pleimann/reptile-monitor/jlc_board/reptile-monitor-2.png

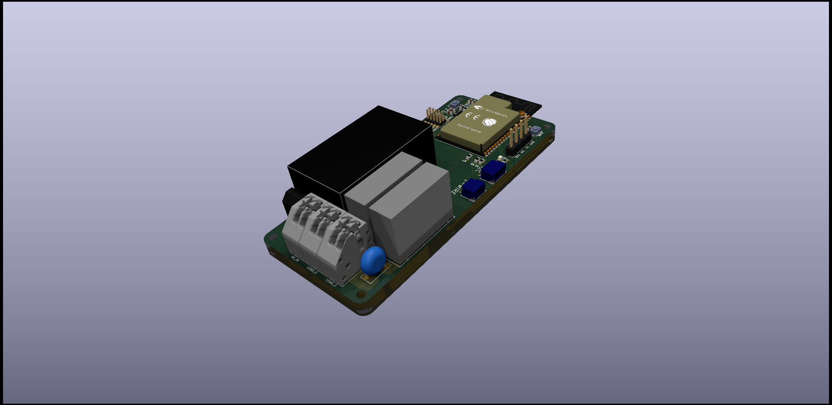
jlc_board/reptile-monitor-2.png
