pleimann/reptile-monitor/jlc_board/reptile-monitor.png

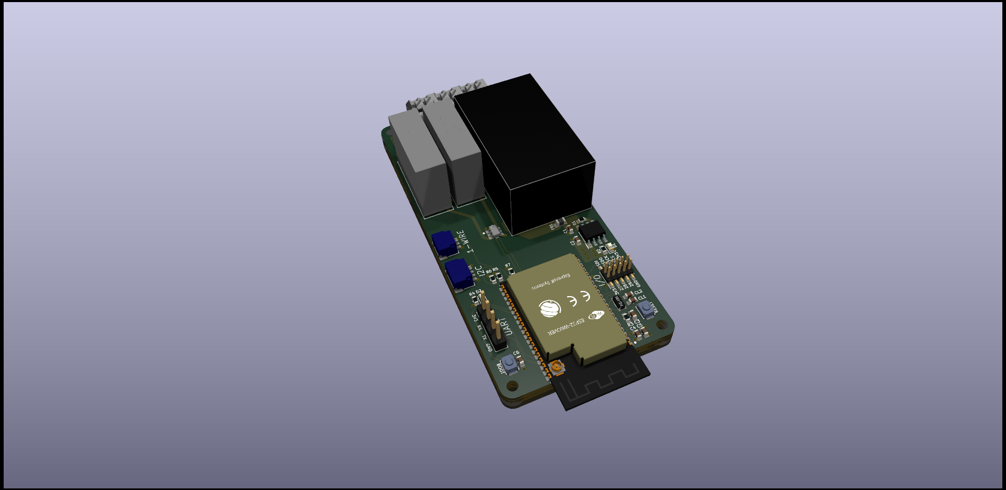
jlc_board/reptile-monitor.png
