pleimann/reptile-monitor/jlc_board/reptile-monitor-3.png

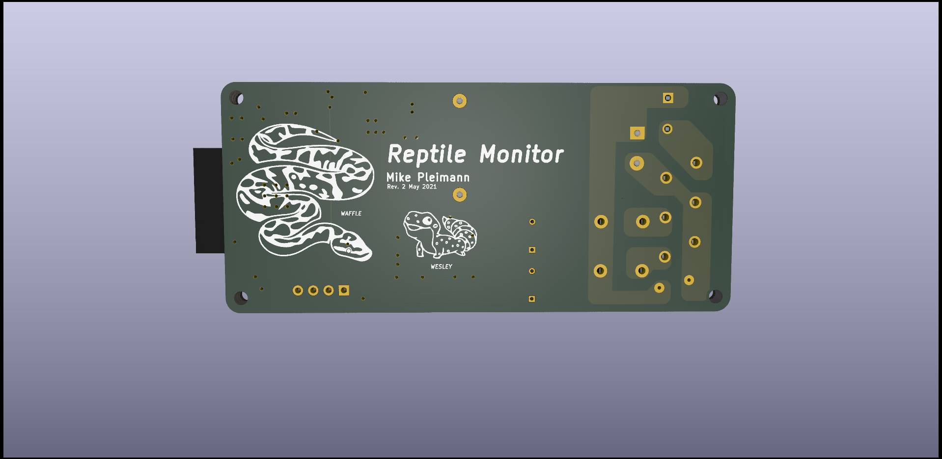
jlc_board/reptile-monitor-3.png
