pleimann/reptile-monitor/jlc_board/reptile-monitor.csv_lcsc.xlsx

LCSC Part Number | Customer # | Package | Quoted Manufacturer | Quoted LCSC Part Number | Quantity | Unit Price | Quantity Available | Min\Mult Order Qty | RoHS | Part Match Confidence
C115357 | SW2 | Alps_SKRK | ALPSALPINE | C115357 | 10 | 0.1092 | 73420 | 5\5 | yes | 100%
C85713 | CL3 | C_0603_1608Metric | Samsung Electro-Mechanics | C85713 | 100 | 0.0127 | 1380300 | 50\50 | yes | 100%
C1648 | CL1,C5,CL2,C6 | C_0603_1608Metric | Samsung Electro-Mechanics | C1648 | 200 | 0.0063 | 204800 | 50\50 | yes | 100%
C84419 | C8 | C_0603_1608Metric | Murata Electronics | C84419 | 100 | 0.0263 | 576010 | 10\10 | yes | 100%
C14663 | C10,C3,C2,C7,C9,C4 | C_0603_1608Metric | YAGEO | C14663 | 200 | 0.0048 | 5368400 | 50\50 | yes | 100%
C209903 | PS1 | Converter_ACDC_HiLink_HLK-PMxx | HI-LINK | C209903 | 1 | 3.7382 | 391 | 1\1 | yes | 100%
C271654 | Y1 | Crystal_SMD_3215-2Pin_3.2x1.5mm | TKD | C271654 | 10 | 0.3138 | 47140 | 1\1 | yes | 100%
C192316 | D1,D2 | LED_0603_1608Metric | TOGIALED | C192316 | 40 | 0.0316 | 47860 | 20\20 | yes | 100%
C192562 | J7 | Molex_Micro-Fit_3.0_43650-0215_1x02_P3.00mm_Vertical | MOLEX | C192562 | 6 | 0.505 | 4320 | 1\1 | yes | 100%
C81162 | U5,U4 | ON_Semiconductor-318-08-01_2018-AS | ON Semiconductor | C81162 | 4 | 0.3129 | 4 | 1\1 | yes | 100%
C706896 | J3 | PinHeader_2x06_P2.54mm_Vertical | XKB Connectivity | C706896 | 5 | 0.1811 | 1631 | 1\1 | yes | 100%
C441897 | R12,R11,R1,R10 | R_0603_1608Metric | PANASONIC | C441897 | 40 | 0.021 | 21520 | 20\20 | yes | 100%
C491194 | R4,R7 | R_0603_1608Metric | PANASONIC | C491194 | 40 | 0.0372 | 4720 | 20\20 | yes | 100%
C22775 | R8,R13 | R_0603_1608Metric | UNI-ROYAL(Uniroyal Elec) | C22775 | 200 | 0.0018 | 304400 | 100\100 | yes | 100%
C427304 | R5 | R_0603_1608Metric | PANASONIC | C427304 | 40 | 0.0582 | 3650 | 10\10 | yes | 100%
C336878 | R9 | R_0603_1608Metric | PANASONIC | C336878 | 40 | 0.0202 | 18640 | 20\20 | yes | 100%
C491172 | R6 | R_0603_1608Metric | PANASONIC | C491172 | 40 | 0.0595 | 3010 | 10\10 | yes | 100%
C165948 | J1 | USB_C_Receptacle_HRO_TYPE-C-31-M-12 | Korean Hroparts Elec | C165948 | 5 | 0.3282 | 95778 | 1\1 | yes | 100%
