pleimann/reptile-monitor/jlc_board/reptile-monitor-power/reptile-monitor-power.step

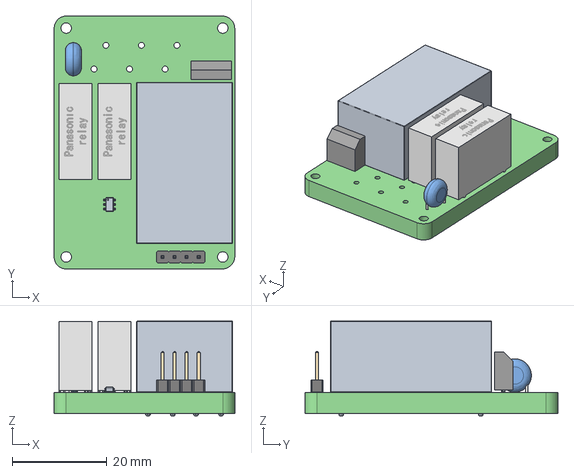
[picture p4: CAD file, 2021-09-04]
jlc_board/reptile-monitor-power/reptile-monitor-power.step
38.1 x 53.3 x 20.0 mm
