pleimann/reptile-monitor/tt-relay-board/tt-relay-board.step

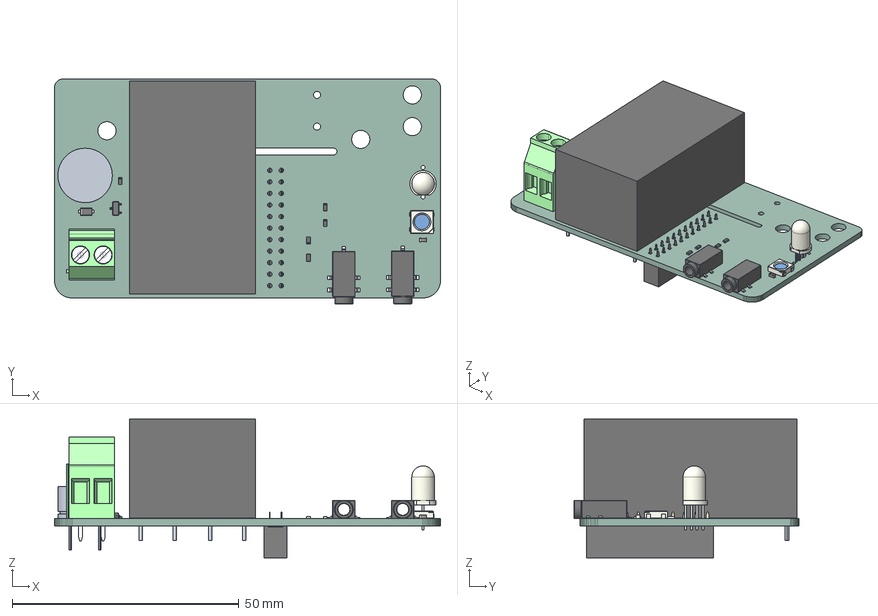
[picture p5: CAD file, 2026-07-09]
tt-relay-board/tt-relay-board.step
85.1 x 49.6 x 30.6 mm
_autosave-tt-relay-board PCB
