pleimann/reptile-monitor/tt-relay-board/tt-relay-board.kicad_pcb

## KiCad design tt-relay-board/tt-relay-board.kicad_pcb (2026-07-09)

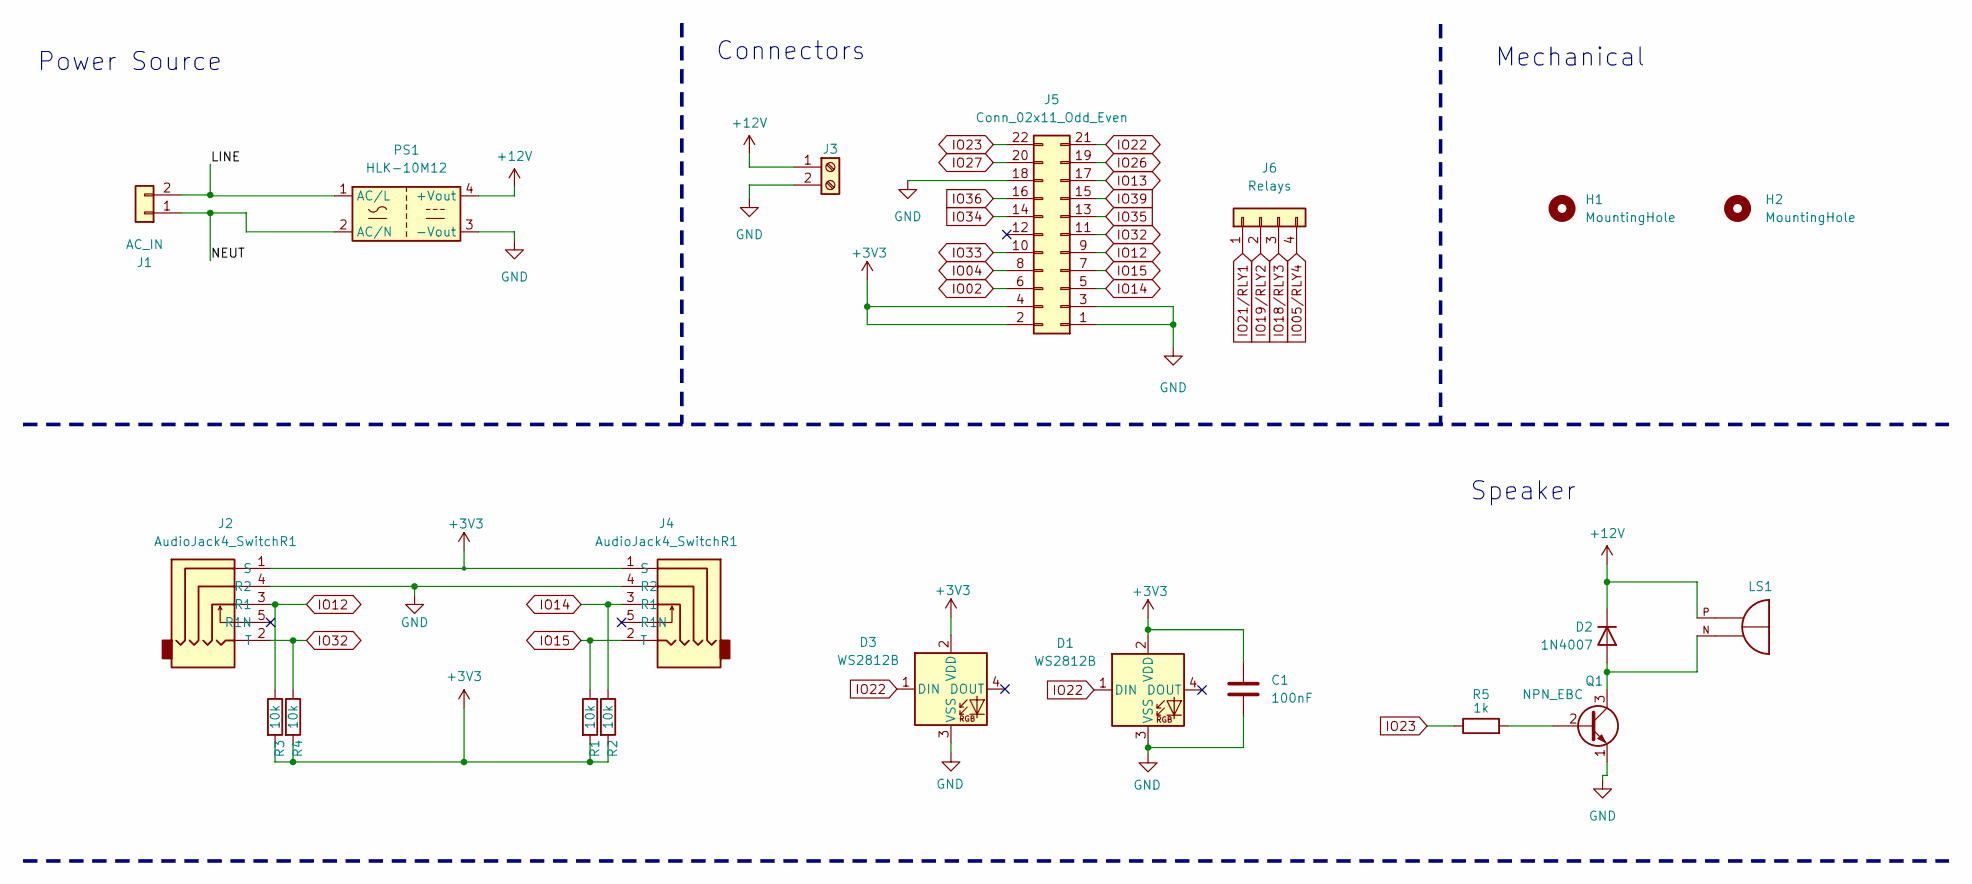
[picture p6: schematic tt-relay-board.kicad_sch]

Parts:
C1: 100nF; C_0603_1608Metric_Pad1.08x0.95mm_HandSolder
D1: WS2812B; LED_D5.0mm-4_RGB_Wide_Pins
D2: 1N4007; D_SOD-123F
D3: WS2812B; LED_WS2812B_PLCC4_5.0x5.0mm_P3.2mm
H1, H2: MountingHole; MountingHole_4mm
J1: AC_IN; SolderWire-0.75sqmm_1x02_P7mm_D1.25mm_OD3.5mm_Relief
J2, J4: AudioJack4_SwitchR1; Korean Hroparts Elec PJ-227-5A; LCSC Part C145819
J3: Screw_Terminal_01x02; SHDR2W110P0X500_1X2_1000X1120X
J5: Conn_02x11_Odd_Even; PinSocket_2x11_P2.54mm_Vertical
J6: Relays
LS1: XDCR_KSSG1201-16; mouser part number 539-AST7525MATRQ; digikey description AUDIO MAGNETIC XDCR 2.5-4.5V SMD
PS1: HLK-10M12; Converter_ACDC_HiLink_HLK-10Mxx
Q1: NPN_EBC; SOT-23
R1, R2, R3, R4: 10k; R_0603_1608Metric_Pad0.98x0.95mm_HandSolder
R5: 1k; R_0603_1608Metric_Pad0.98x0.95mm_HandSolder

Connections:
+3V3: C1.1, D1.2 (VDD), D3.2 (VDD), J2.1 (S), J4.1 (S), J5.2, J5.4, R1.2, R2.2, R3.2, R4.2
+12V: D2.1 (K), J3.1, LS1.P, PS1.4 (+Vout)
/LINE: J1.2, PS1.1 (AC/L)
/NEUT: J1.1, PS1.2 (AC/N)
GND: C1.2, D1.3 (VSS), D3.3 (VSS), J2.4 (R2), J3.2, J4.4 (R2), J5.1, J5.3, J5.18, PS1.3 (-Vout), Q1.1 (E)
IO02: J5.6
IO04: J5.8
IO12: J2.3 (R1), J5.9, R3.1
IO13: J5.17
IO14: J4.3 (R1), J5.5, R2.1
IO15: J4.2 (T), J5.7, R1.1
IO22: D1.1 (DIN), D3.1 (DIN), J5.21
IO23: J5.22, R5.1
IO26: J5.19
IO27: J5.20
IO32: J2.2 (T), J5.11, R4.1
IO33: J5.10
IO34: J5.14
IO35: J5.13
IO36: J5.16
IO39: J5.15
unnamed: D2.2 (A), LS1.N, Q1.3 (C)
unnamed: Q1.2 (B), R5.2

Notes on the sheet:
Power Source
Speaker
Mechanical
Connectors

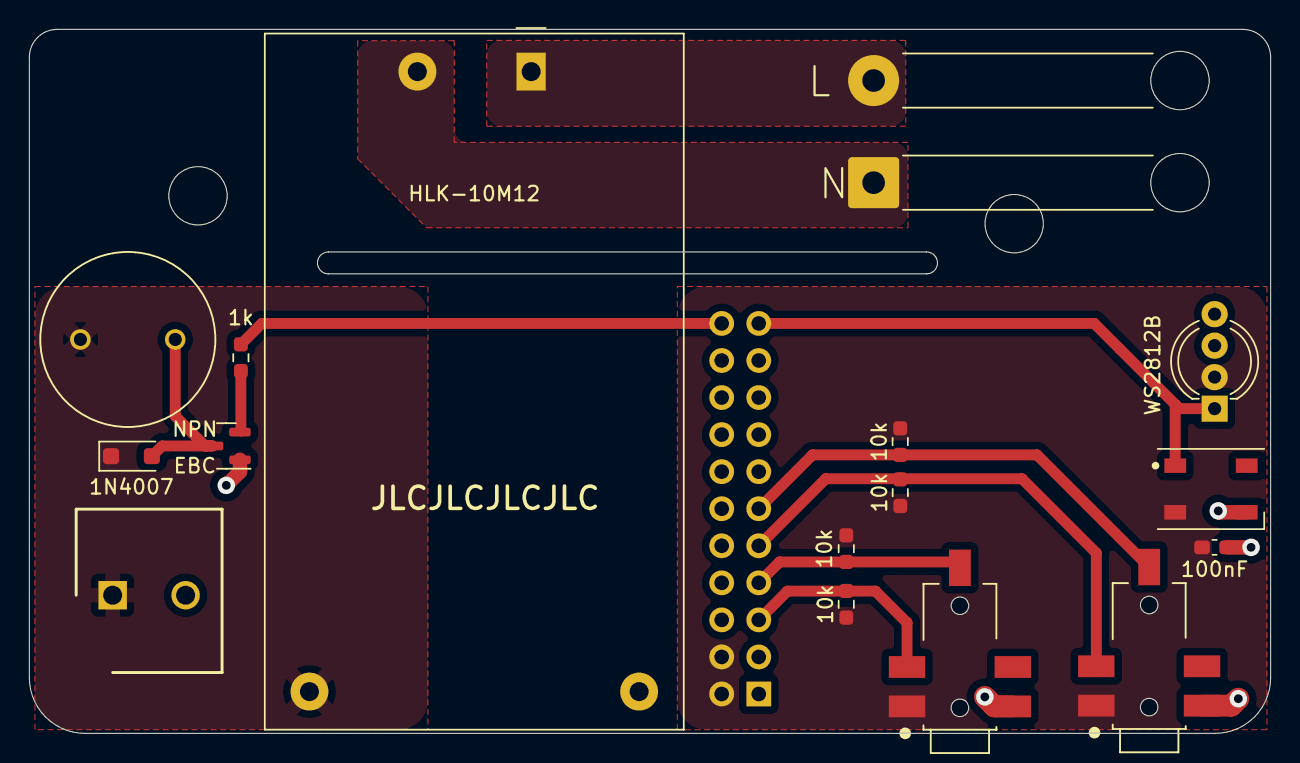
[picture p7: board tt-relay-board.kicad_pcb from above]

Board: 2 copper layers, 85.1 x 48.3 mm, 19 parts (1 on the bottom side), 13 nets.
