pleimann/reptile-monitor/connector-joint-v2/connector-joint.kicad_pcb

## KiCad design connector-joint-v2/connector-joint.kicad_pcb (2026-07-09)

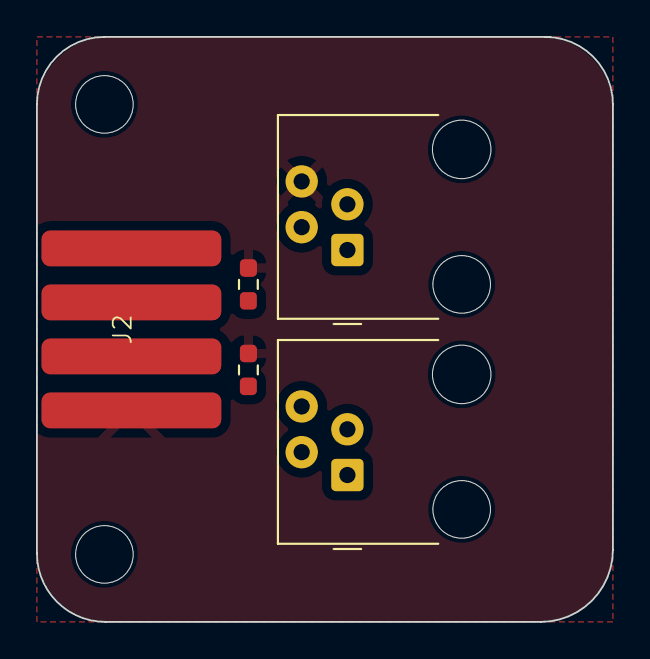
[picture p8: board connector-joint-v2/connector-joint.kicad_pcb from above]

Board: 2 copper layers, 32.0 x 32.5 mm, 7 parts (0 on the bottom side), 4 nets, no tracks yet.

Parts:
H1, H2: MountingHole; MountingHole_3.2mm_M3
J2: Conn_01x04; SolderPad_x4
J4, J5: 4P4C; RJ9_Evercom_5301-440xxx_Horizontal
R1, R2: R_US; R_0603_1608Metric_Pad0.98x0.95mm_HandSolder

Connections:
+3V3: J2.4 (3V3), J4.3, J5.2
GND: J2.3 (GND), J4.2, J5.3, R2.2
unnamed: J2.1 (DATA), J4.4, R1.1, R2.1
unnamed: J2.2 (DATA), J4.1, J5.4, R1.2
