pleimann/reptile-monitor/connector-joint/connector-joint.kicad_pcb

## KiCad design connector-joint/connector-joint.kicad_pcb (2023-07-17)

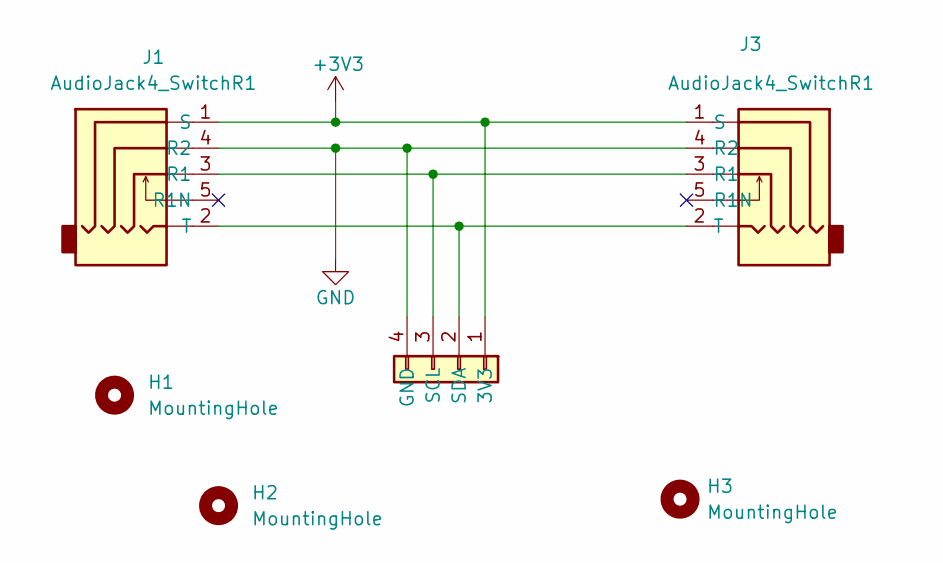
[picture p9: schematic connector-joint.kicad_sch]

Parts:
H1, H2, H3: MountingHole; MountingHole_3.2mm_M3
J1, J3: AudioJack4_SwitchR1; Korean Hroparts Elec PJ-227-5A; LCSC Part C145819
J2: Conn_01x04; SolderWire-0.15sqmm_1x04_P4mm_D0.5mm_OD1.5mm

Connections:
+3V3: J1.1 (S), J2.1, J3.1 (S)
GND: J1.4 (R2), J2.4, J3.4 (R2)
unnamed: J1.2 (T), J2.2, J3.2 (T)
unnamed: J1.3 (R1), J2.3, J3.3 (R1)

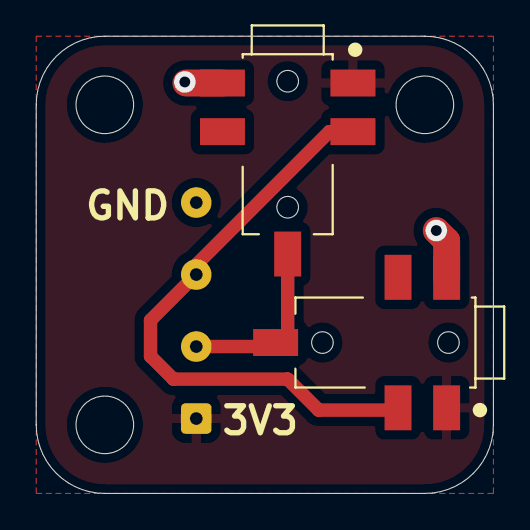
[picture p10: board connector-joint/connector-joint.kicad_pcb from above]

Board: 2 copper layers, 25.4 x 25.4 mm, 6 parts (0 on the bottom side), 4 nets.
