pleimann/reptile-monitor/jlc_board/reptile-monitor-power/reptile-monitor-power.kicad_pcb

## KiCad design jlc_board/reptile-monitor-power/reptile-monitor-power.kicad_pcb (2023-07-17)

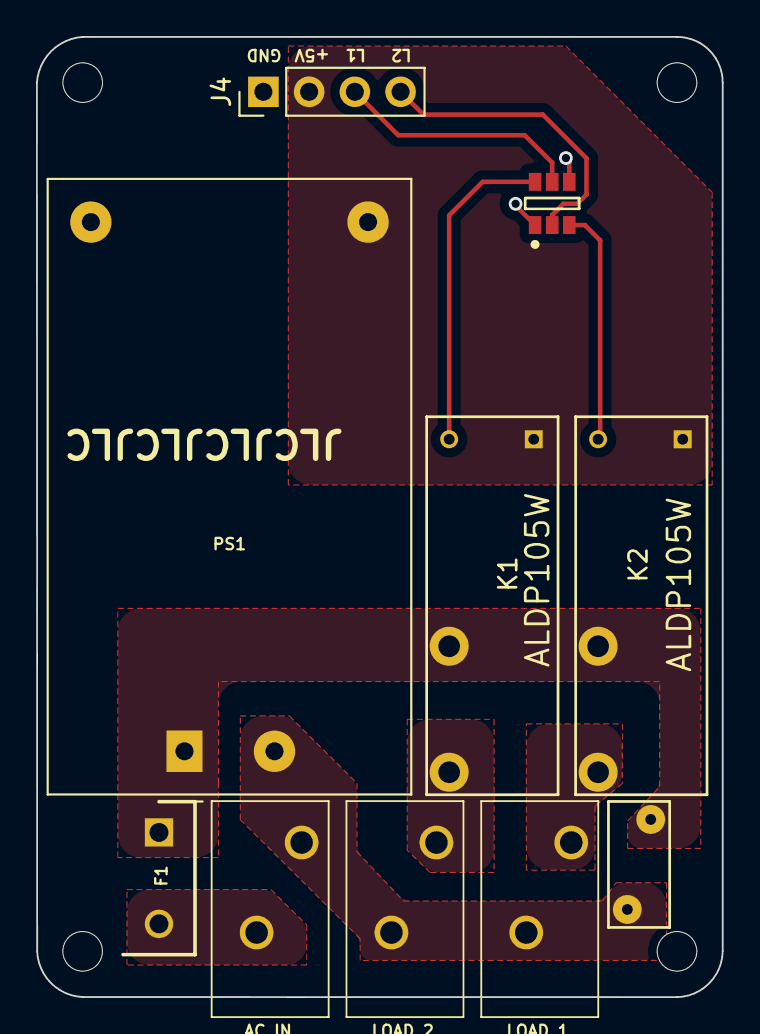
[picture p11: board reptile-monitor-power.kicad_pcb from above]

Board: 4 copper layers, 38.1 x 53.3 mm, 14 parts (0 on the bottom side), 11 nets.

Parts:
F1: 39208000440; TO508P400X850X850-2P
J1: AC_IN; TE Connectivity PC Terminal Block 128340212
J2: LOAD_2; TE Connectivity PC Terminal Block 128340212
J3: LOAD_1; TE Connectivity PC Terminal Block 128340212
J4: POWER CONN; PinHeader_1x04_P2.54mm_Vertical
K1, K2: ALDP105W; Panasonic-ALDP105W-Manufacturer_Recommended
PS1: HLK-PM01; Converter_ACDC_HiLink_HLK-PMxx
REF1, REF1#2, REF1#3, REF1#4: MountingHole_2.2mm_M2_ISO7380
RV1: Varistor; RV_Disc_D7mm_W3.4mm_P5mm
U1: NUD3105DMT1G; ON_Semi-318F-0-0-0

Connections:
+5V: J4.2, K1.1, K2.1, PS1.4 (+Vout)
/FUSED_AC_L: F1.1, K1.3 (COM), K2.3 (COM), PS1.1 (AC/L), RV1.2
/LOAD1: J3.2, K2.2 (NO)
/LOAD2: J2.2, K1.2 (NO)
GND: J4.1, PS1.3 (-Vout), U1.1 (1_Source), U1.4 (2_Source)
L1: J4.3, U1.5 (2_Gate)
L2: J4.4, U1.2 (1_Gate)
LINE: F1.2, J1.1
NEUT: J1.2, J2.1, J3.1, PS1.2 (AC/N), RV1.1
RLY1: K2.4, U1.3 (2_Drain)
RLY2: K1.4, U1.6 (1_Drain)
