pleimann/reptile-monitor/jlc_board/reptile-monitor.kicad_pcb

## KiCad design jlc_board/reptile-monitor.kicad_pcb (2022-04-24)

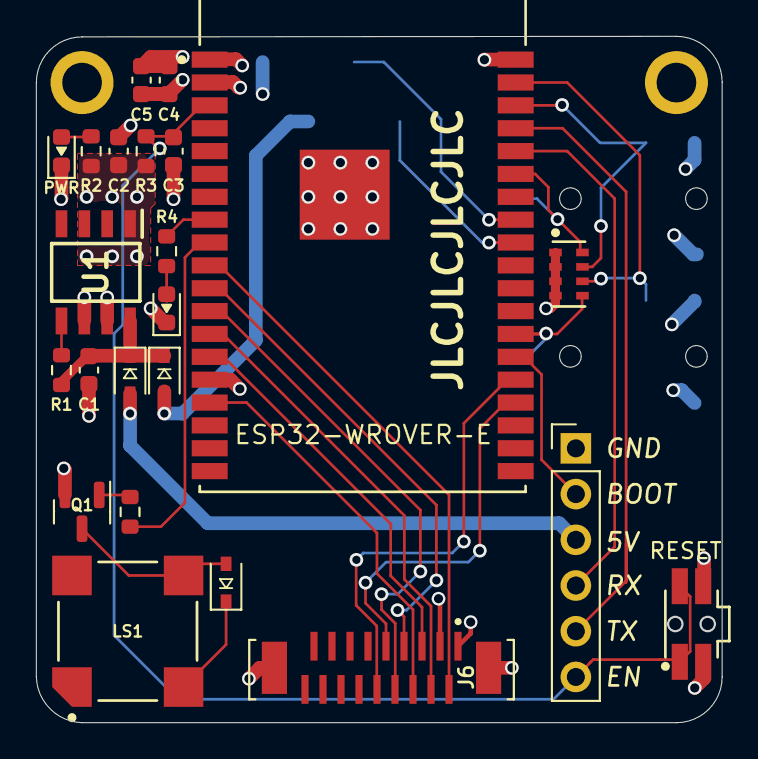
[picture p12: board reptile-monitor.kicad_pcb from above]

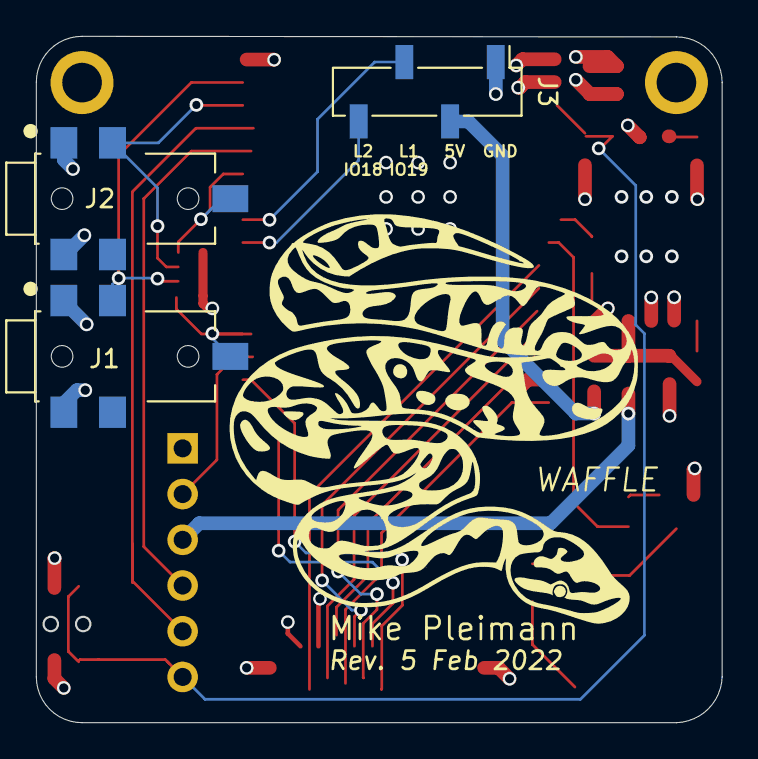
[picture p13: board reptile-monitor.kicad_pcb from below]

Board: 4 copper layers, 38.1 x 38.1 mm, 29 parts (4 on the bottom side), 31 nets.

Parts:
C1, C2: 1u; C_0603_1608Metric
C3, C5: 100n; C_0603_1608Metric
C4: 22u; C_0603_1608Metric
D1: PWR; LED_0603_1608Metric
D2: 32; LED_0603_1608Metric
D3, D4, D5: 1N4007; D_SOD-323
H1, H2: MountingHole; MountingHole_2.2mm_M2_ISO7380_Pad
J1, J2: AudioJack4_SwitchR1; Korean Hroparts Elec PJ-227-5A
J3: PWR CONN; PinSocket_1x04_P2.54mm_Vertical_SMD_Pin1Left
J4: UART; PinHeader_1x06_P2.54mm_Vertical
J6: 18-Lead FPC 0.5 mm - Vertical; TE_1-1734742-8
LS1: AST7525MATRQ; Mallory_Sonalert_Products_Inc-AST7525MATRQ-0-0-MFG
MD1: ESP32-WROVER-E; Espressif_Systems-ESP32-WROVER-0-0-MFG
Q1: Q_NPN_BEC; SOT-23
R1, R2, R3: 10k; R_0603_1608Metric
R4: 1k; R_0603_1608Metric
R5: 1K; R_0603_1608Metric
RN1: 10k; Panasonic-EXB-V8V103JV-0
SW1: RESET; Panasonic-EVQ-P7A01P
U1: AP2112M-3.3; SOIC127P600X170-8N
WAFFLE: LOGO

Connections:
+3V3: C2.2, C4.1, C5.1, J1.1 (S), J2.1 (S), J6.1, MD1.2 (VDD33), R2.1, R3.2, RN1.1 (R1.1), RN1.2 (R2.1), RN1.3 (R3.1), RN1.4 (R4.1), U1.1 (VOUT)
+5V: C1.1, D4.1 (K), D5.1 (K), R1.2, U1.8 (VIN)
/LED: MD1.8 (IO32), R4.2
/PWR_EN: R1.1, U1.5 (EN)
BK_LT: J6.2, MD1.10 (IO25)
BOOT: J4.2, MD1.25 (IO0)
BUZZER: MD1.9 (IO33), R5.1
DS_0: J1.3 (R1), MD1.37 (IO23), RN1.6 (R3.2)
DS_DATA: J1.2 (T), MD1.26 (IO4), RN1.5 (R4.2)
EN: C3.2, J4.6, MD1.3 (EN), R3.1, SW1.1, SW1.1'
GND: C1.2, C2.1, C3.1, C4.2, C5.2, D1.1 (K), D2.1 (K), H1.1, H2.1, J1.4 (R2), J2.4 (R2), J3.1, J4.1, J6.3, J6.S1 (SHIELD), J6.S2 (SHIELD), MD1.1 (GND), MD1.15 (GND), MD1.38 (GND), MD1.39 (GND), Q1.2 (E), SW1.2, SW1.2', U1.6 (GND_1), U1.7 (GND_2)
L1: J3.3, MD1.31 (IO19)
L2: J3.4, MD1.30 (IO18)
unnamed: D1.2 (A), R2.2
unnamed: D2.2 (A), R4.1
unnamed: D3.2 (A), LS1.4 (-), Q1.3 (C)
unnamed: D5.2 (A), J3.2
unnamed: D4.2 (A), J4.3
unnamed: Q1.1 (B), R5.2
RXD0: J4.4, MD1.34 (RXD0)
SCL0: J2.3 (R1), MD1.36 (IO22), RN1.7 (R2.2)
SDA0: J2.2 (T), MD1.33 (IO21), RN1.8 (R1.2)
SD_CS: J6.10, MD1.24 (IO2)
SPI_SCK: J6.4, MD1.13 (IO14)
SPI_SDI: J6.5, MD1.14 (IO12)
SPI_SDO: J6.6, MD1.16 (IO13)
TFT_CS: J6.9, MD1.23 (IO15)
TFT_DC: J6.7, MD1.11 (IO26)
TFT_RST: J6.8, MD1.12 (IO27)
TXD0: J4.5, MD1.35 (TXD0)
VDD: D3.1 (K), LS1.3 (+)
