pleimann/reptile-monitor/(commit log)

2021-03-12 add enclosure controllers
2021-04-18 JLC Board V1.0
    [reptile-monitor-s2.kicad_pcb, reptile-monitor-s2.kicad_sch, reptile-monitor.csv, reptile-monitor.csv_lcsc.xlsx, reptile-monitor.kicad_pcb, reptile-monitor.kicad_sch]
2021-04-22 Rev2 - Change to Panasonic relays as they're actually attainable and cheaper.
    [reptile-monitor-rev2.csv, reptile-monitor.kicad_pcb, reptile-monitor.kicad_sch]
2021-04-22 Change ALPS to Omron boot and reset buttons cause they're available from Digi-Key
    [reptile-monitor.kicad_pcb, reptile-monitor.kicad_sch]
2021-05-09 rev 2
    [reptile-monitor-B_Mask.gbr, reptile-monitor-B_Paste.gbr, reptile-monitor-B_Silkscreen.gbr, reptile-monitor-Back.gbr, reptile-monitor-Edge_Cuts.gbr, reptile-monitor-F_Mask.gbr, reptile-monitor-F_Paste.gbr, reptile-monitor-F_Silkscreen.gbr]
2021-05-19 Rev2 - Waffle & Wesley
    [reptile-monitor.csv, reptile-monitor.kicad_pcb, reptile-monitor.kicad_sch]
2021-05-19 move ibom to board dir
2021-09-04 Revision 3
    [reptile-monitor.kicad_pcb, reptile-monitor.kicad_sch]
2021-09-04 separate power board
    [reptile-monitor-pwr.kicad_sch, reptile-monitor-pwr1.kicad_pcb, reptile-monitor.kicad_sch]
2021-09-04 move quiic connector to same side as TRRS sensor connectors so that all connectors are on the same side
    [reptile-monitor.kicad_pcb, reptile-monitor.kicad_sch]
2021-09-04 Rev 3 - separate power board
    [reptile-monitor-power-B_Cu.gbr, reptile-monitor-power-B_Mask.gbr, reptile-monitor-power-B_Paste.gbr, reptile-monitor-power-B_Silkscreen.gbr, reptile-monitor-power-Edge_Cuts.gbr, reptile-monitor-power-F_Cu.gbr, reptile-monitor-power-F_Mask.gbr, reptile-monitor-power-F_Paste.gbr]
2021-09-04 v4 reorganization complete
    [reptile-monitor.kicad_pcb, reptile-monitor.kicad_sch]
2021-09-04 consolidate kicad libraries
    [reptile-monitor-power-B_Cu.gbr, reptile-monitor-power-B_Mask.gbr, reptile-monitor-power-B_Paste.gbr, reptile-monitor-power-B_Silkscreen.gbr, reptile-monitor-power-Edge_Cuts.gbr, reptile-monitor-power-F_Cu.gbr, reptile-monitor-power-F_Mask.gbr, reptile-monitor-power-F_Paste.gbr]
2021-09-07 add raight angle tactile switch
    [reptile-monitor.kicad_pcb, reptile-monitor.kicad_sch]
2021-10-16 Change LED value to remove IO5 confusion
    [reptile-monitor.kicad_sch]
2021-12-09 Eliminate I2C Chip & move stemma qt connector to top
    [reptile-monitor.kicad_pcb, reptile-monitor.kicad_sch]
2021-12-09 change blu led to 1k resistor so it's brighter
    [reptile-monitor.kicad_pcb]
2023-08-04 Fix component positions in tt-relay-board
    [tt-relay-board.kicad_pcb, tt-relay-board.kicad_sch]
2026-07-09 Update boards, add connector-joint-v2, ignore backups & .DS_Store
    - Add connector-joint-v2 and reptile_west esphome config
    - Swap tt-relay-board to HLK-10M12 converter; add fuse holder,
    RGB LED, and transducer footprints/3D models
    - Remove tracked KiCad backup zips and autosave files
    - Gitignore board backup dirs and .DS_Store
